Thamizharasan007/Vision-Based-Automated-Conveyor-Sorting-System/media/photos/BACK_VIEW.jpeg

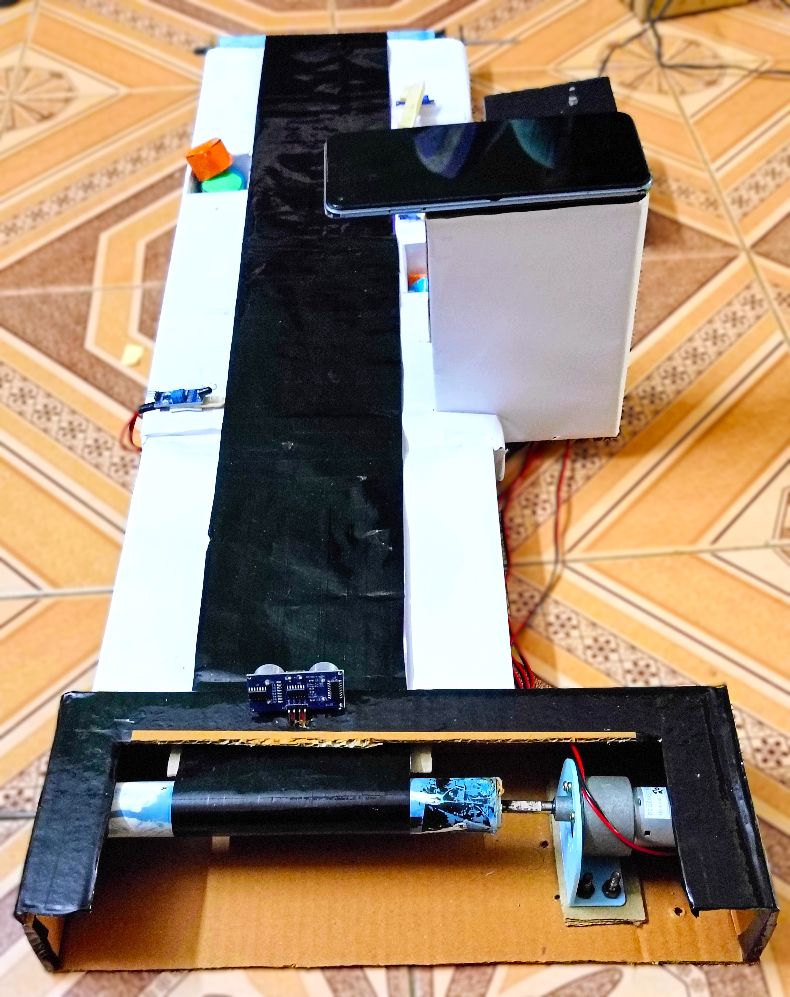
media/photos/BACK_VIEW.jpeg
