Thamizharasan007/Vision-Based-Automated-Conveyor-Sorting-System/media/photos/FRONT_VIEW.jpeg

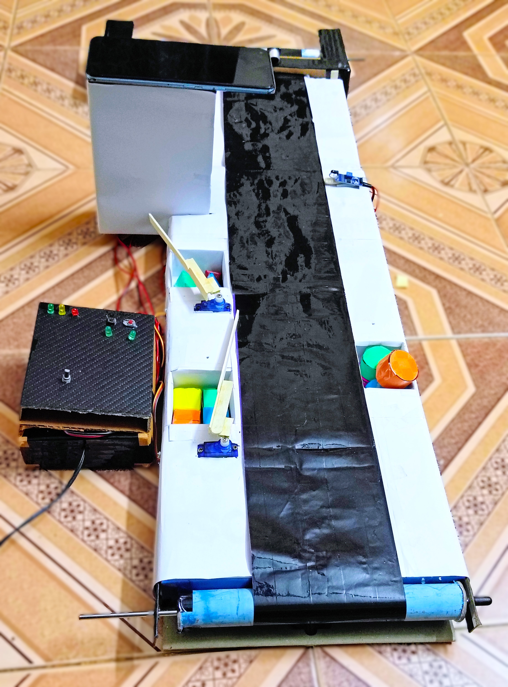
media/photos/FRONT_VIEW.jpeg
