Thamizharasan007/Vision-Based-Automated-Conveyor-Sorting-System/media/photos/ISOMETRIC _VIEW.jpeg

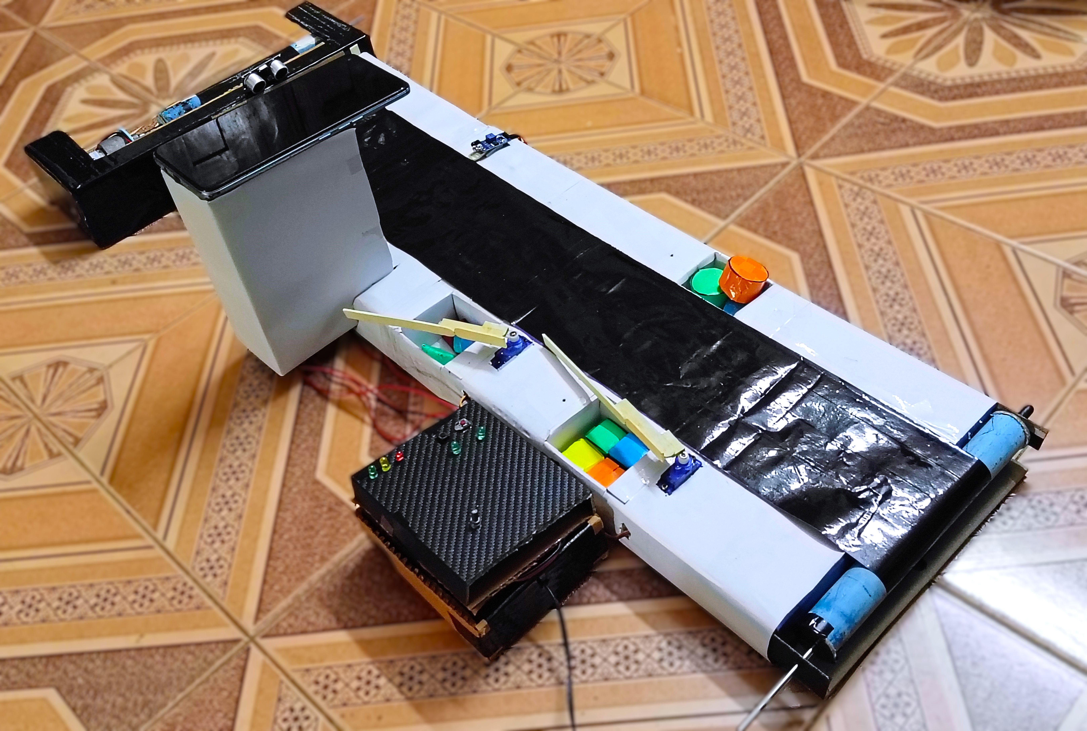
media/photos/ISOMETRIC _VIEW.jpeg
