Thamizharasan007/Vision-Based-Automated-Conveyor-Sorting-System/media/photos/ISOMETRIC_VIEW_2.jpeg

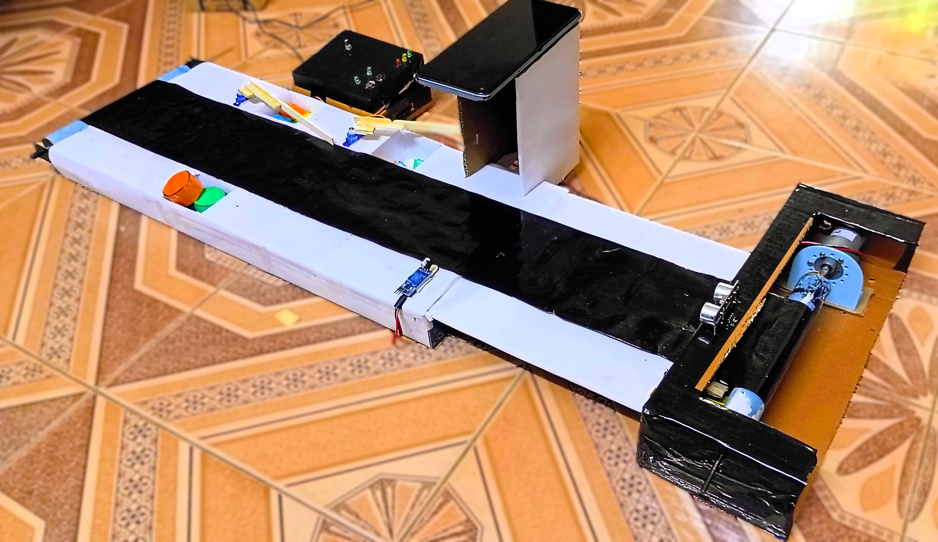
media/photos/ISOMETRIC_VIEW_2.jpeg
