Thamizharasan007/Vision-Based-Automated-Conveyor-Sorting-System/media/photos/MOTOR_COUPLING_DETAILED_VIEW.jpeg

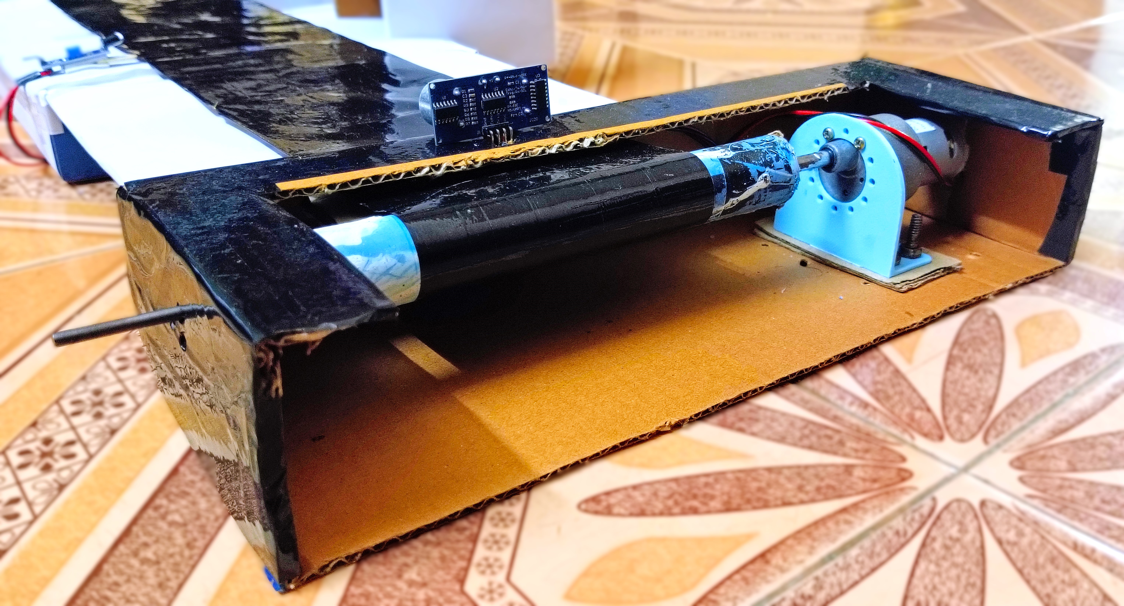
media/photos/MOTOR_COUPLING_DETAILED_VIEW.jpeg
