Thamizharasan007/Vision-Based-Automated-Conveyor-Sorting-System/media/photos/OBJECT_DETECTION_SENSOR_PLACEMENT.jpeg

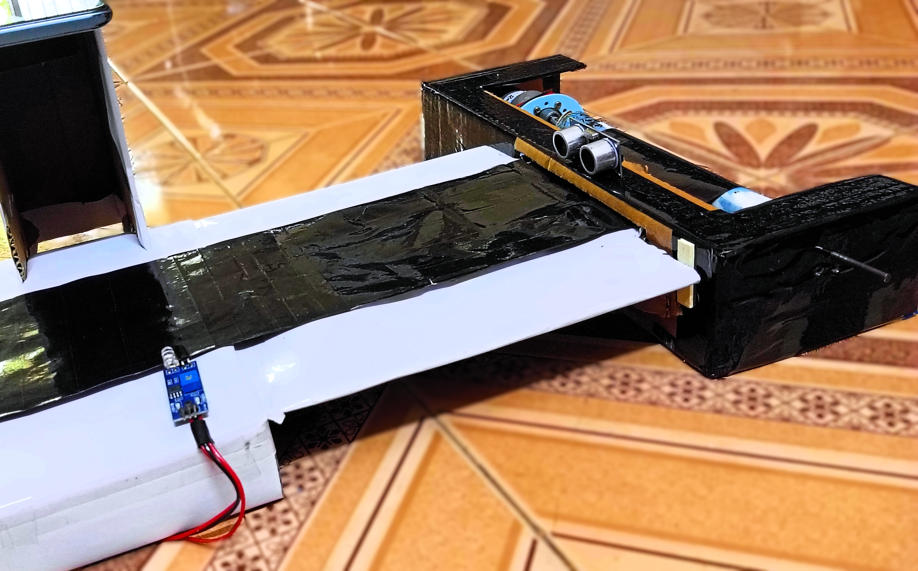
media/photos/OBJECT_DETECTION_SENSOR_PLACEMENT.jpeg
