Thamizharasan007/Vision-Based-Automated-Conveyor-Sorting-System/media/photos/SORTING_SYSTEM.jpeg

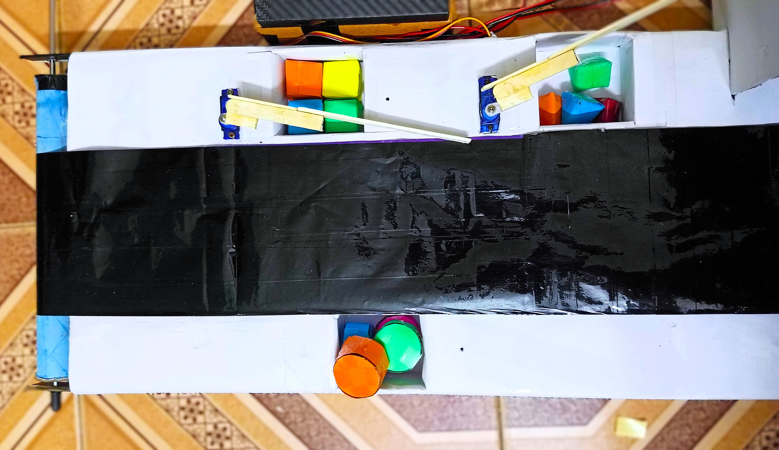
media/photos/SORTING_SYSTEM.jpeg
