Thamizharasan007/Vision-Based-Automated-Conveyor-Sorting-System/media/photos/TOP_VIEW.jpeg

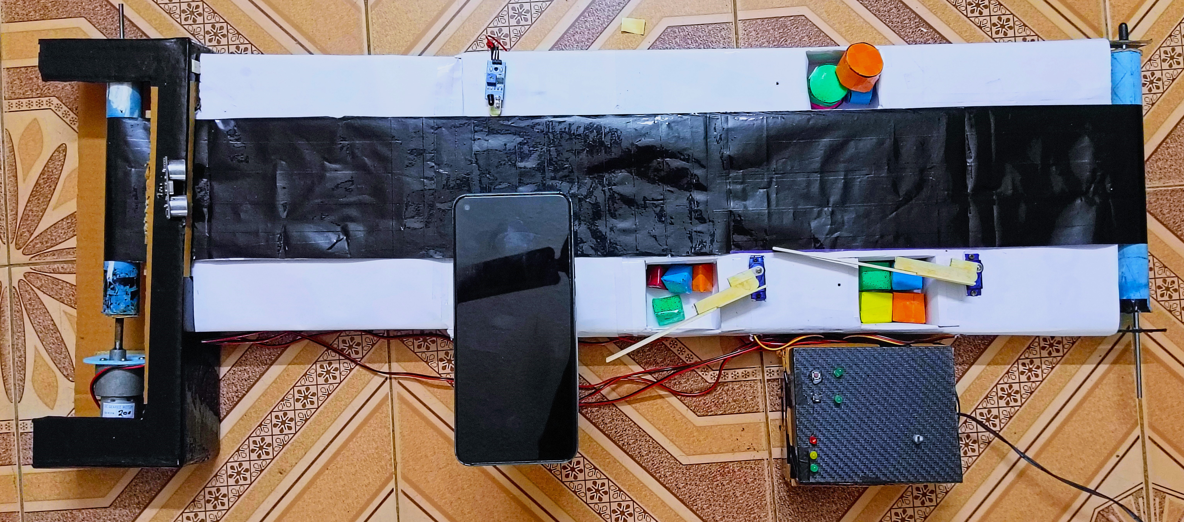
media/photos/TOP_VIEW.jpeg
