Thamizharasan007/Vision-Based-Automated-Conveyor-Sorting-System/mechanical-design/Coupler for Motor.STL

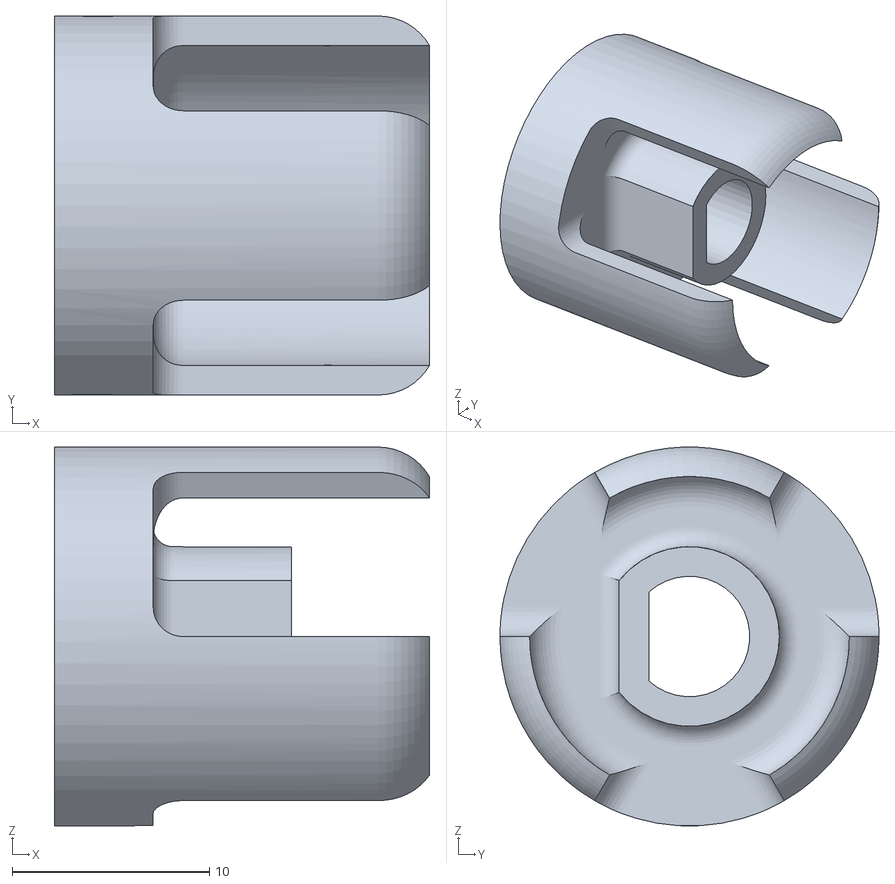
[picture p10: CAD file, 2026-10-25]
mechanical-design/Coupler for Motor.STL
19.0 x 19.2 x 19.2
