Thamizharasan007/Vision-Based-Automated-Conveyor-Sorting-System/mechanical-design/Motor_Clamp.STL

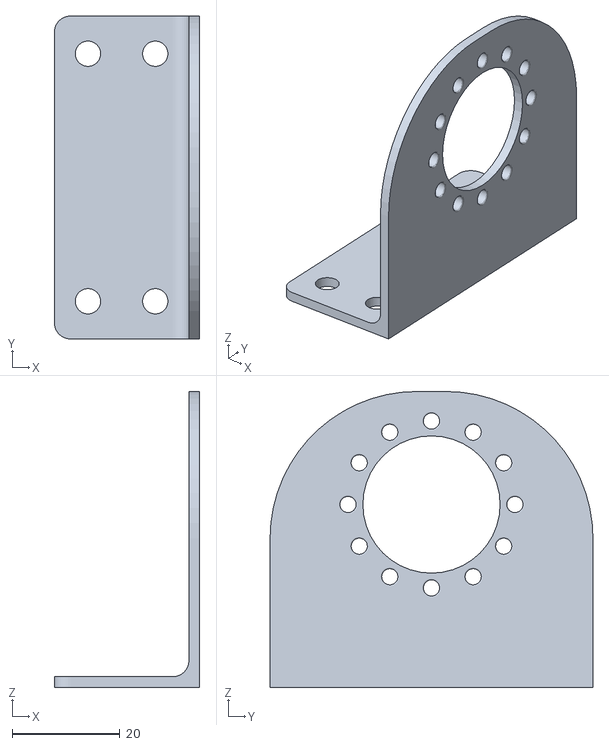
[picture p11: CAD file, 2026-10-25]
mechanical-design/Motor_Clamp.STL
27.0 x 60.0 x 55.0
