Thamizharasan007/Vision-Based-Automated-Conveyor-Sorting-System/(commit log)

2026-10-25 Create motor_bracket
2026-10-29 Create Circuit-Diagram
2026-10-29 Add power requirements and safety documentation
    This document outlines the power requirements and electrical safety considerations for the Vision-Based Automated Conveyor Sorting System, detailing specifications for various components, supply guidelines, and a pre-power safety checklist.
2026-10-29 Update number of green LEDs in wiring guide
2026-10-29 Implement real-time shape detection from camera feed
    This script captures video from a mobile phone camera and detects shapes in real-time using contour analysis. It classifies shapes as triangle, square, rectangle, circle, or other based on contour properties.
2026-10-29 Add camera configuration settings
    Added shared configuration for mobile phone IP camera.
2026-10-29 Add system test plan for conveyor sorting system
    This document outlines the test procedures, environment, status conventions, and test cases for the vision-based conveyor sorting system, covering hardware, software, and various test scenarios.
2026-10-29 Add GPIO pin map documentation for ESP32
    This document details the GPIO assignments for the ESP32 DevKit V1 used in the Vision-Based Automated Conveyor Sorting System, including mode selection, motor connections, sensor connections, and status indicators.
2026-10-31 Refactor main function for ESP32 communication
